ZachHeilig/Microchip-USB-20pin-Smalls/board_image.png

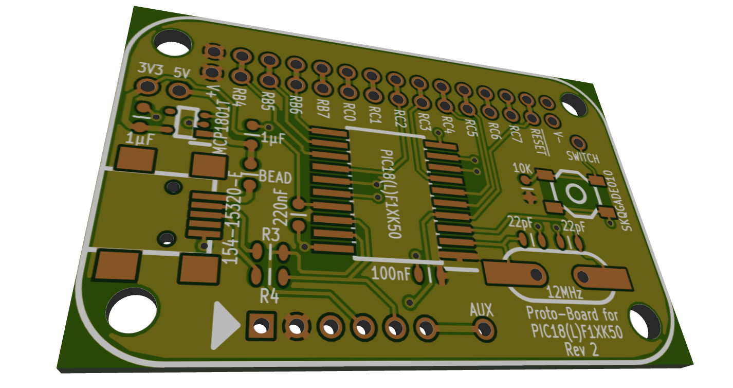
board_image.png
