ZachHeilig/Microchip-USB-20pin-Smalls/Microchip-USB-20pin-Smalls.sch

## KiCad design Microchip-USB-20pin-Smalls.sch (2012-05-12)

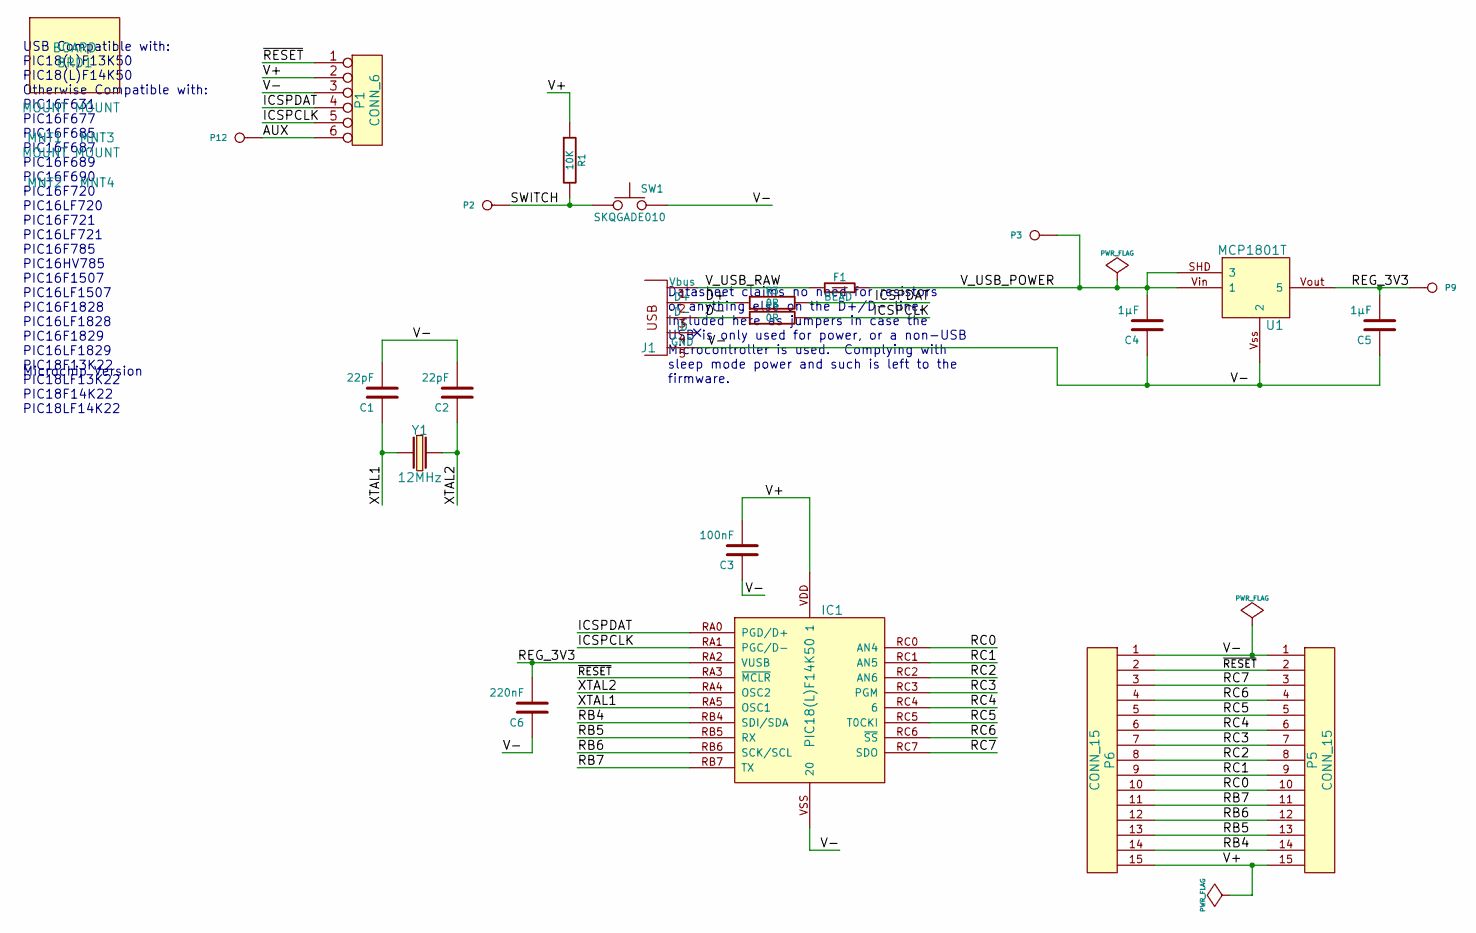
[picture p2: schematic Microchip-USB-20pin-Smalls.sch]

Parts:
BRD1: BOARD
C1, C2: 22pF; SMD1608-NP
C3: 100nF; SMD1608-NP
C4, C5: 1µF; SMD1608-NP
C6: 220nF; SMD1608-NP
F1: BEAD
IC1: PIC18(L)F14K50; PIC-20pin-SOIC-7.5mm
J1: 154-15320-E
MNT1, MNT2, MNT3, MNT4: MOUNT
P1: CONN_6; ROW_HOLES_6
P2: SWITCH; ROW_HOLES_1
P3: USB_5V; ROW_HOLES_1
P5, P6: CONN_15; ROW_HOLES_15
P9: REG_3V3; ROW_HOLES_1
P12: AUX; ROW_HOLES_1
R1: 10K; SMD0603-NP
R3, R4: 0R; SMD0603-NP
SW1: SKQGADE010
U1: MCP1801T; SOT-23-5
Y1: 12MHz

Connections:
AUX: P1.6, P12.1
D+: J1.2 (D+), R3.1
D-: J1.3 (D-), R4.1
ICSPCLK: IC1.RA1 (PGC/D-), P1.5, R4.2
ICSPDAT: IC1.RA0 (PGD/D+), P1.4, R3.2
RB4: IC1.RB4 (SDI/SDA), P5.14, P6.14
RB5: IC1.RB5 (RX), P5.13, P6.13
RB6: IC1.RB6 (SCK/SCL), P5.12, P6.12
RB7: IC1.RB7 (TX), P5.11, P6.11
RC0: IC1.RC0 (AN4), P5.10, P6.10
RC1: IC1.RC1 (AN5), P5.9, P6.9
RC2: IC1.RC2 (AN6), P5.8, P6.8
RC3: IC1.RC3 (PGM), P5.7, P6.7
RC4: IC1.RC4 (6), P5.6, P6.6
RC5: IC1.RC5 (T0CKI), P5.5, P6.5
RC6: IC1.RC6 (~SS~), P5.4, P6.4
RC7: IC1.RC7 (SDO), P5.3, P6.3
REG_3V3: C5.2, C6.2, IC1.RA2 (VUSB), P9.1, U1.Vout (5)
SWITCH: P2.1, R1.2, SW1.1
V+: C3.2, IC1.VDD (1), P1.2, P5.15, P6.15, R1.1
V-: C1.2, C2.2, C3.1, C4.1, C5.1, C6.1, IC1.VSS (20), J1.5 (GND), P1.3, P5.1, P6.1, SW1.2, U1.Vss (2)
V_USB_POWER: C4.2, F1.2, P3.1, U1.Vin (1), U1.~SHD (3)
V_USB_RAW: F1.1, J1.1 (Vbus)
XTAL1: C1.1, IC1.RA5 (OSC1), Y1.1
XTAL2: C2.1, IC1.RA4 (OSC2), Y1.2
~RESET~: IC1.RA3 (~MCLR~), P1.1, P5.2, P6.2

Notes on the sheet:
Datasheet claims no need for resistors or anything else on the D+/D- line. Included here as jumpers in case the USB is only used for power, or a non-USB Microcontroller is used. Complying with sleep mode power and such is left to the firmware.
USB Compatible with: PIC18(L)F13K50 PIC18(L)F14K50 Otherwise Compatible with: PIC16F631 PIC16F677 PIC16F685 PIC16F687 PIC16F689 PIC16F690 PIC16F720 PIC16LF720 PIC16F721 PIC16LF721 PIC16F785 PIC16HV785 PIC16F1507 PIC16LF1507 PIC16F1828 PIC16LF1828 PIC16F1829 PIC16LF1829 PIC18F13K22 PIC18LF13K22 PIC1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
Microchip Version
