ZachHeilig/Microchip-USB-20pin-Smalls/(commit log)

2012-05-12 PIC18F14K50 breakout board to fit in an Altoids Smalls tin.
    [Microchip-USB-20pin-Smalls-Back.gbl, Microchip-USB-20pin-Smalls-Front.gtl, Microchip-USB-20pin-Smalls-Mask_Back.gbs, Microchip-USB-20pin-Smalls-Mask_Front.gts, Microchip-USB-20pin-Smalls-NPTH.drl, Microchip-USB-20pin-Smalls-PCB_Edges.gbr, Microchip-USB-20pin-Smalls-SilkS_Back.gbo, Microchip-USB-20pin-Smalls-SilkS_Front.gto]
2012-05-12 Added note about switch
